nanj-robotics/geni_craner/geni_craner_description/meshes/link6.STL

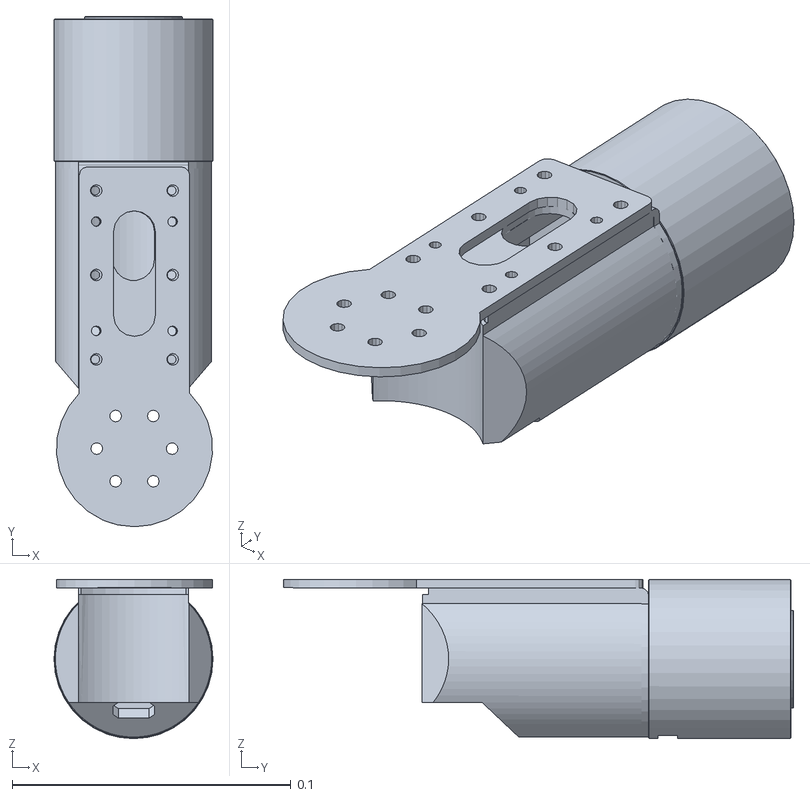
[picture p4: CAD file, 2026-08-13]
geni_craner_description/meshes/link6.STL
0.057 x 0.183 x 0.0571
