nanj-robotics/geni_craner/geni_craner_description/meshes/base_link.STL

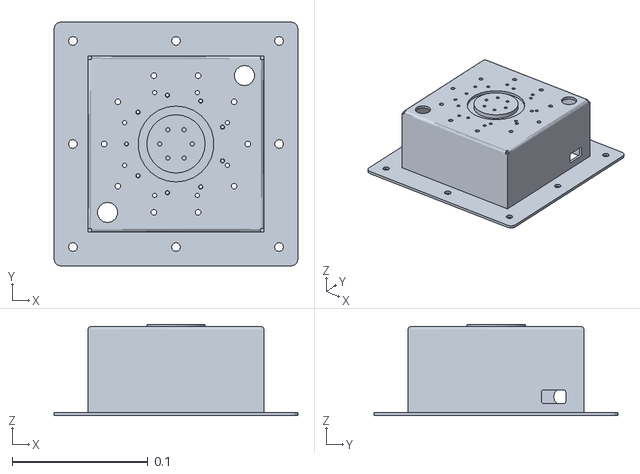
[picture p5: CAD file, 2026-08-13]
geni_craner_description/meshes/base_link.STL
0.18 x 0.18 x 0.0675
