nanj-robotics/geni_craner/geni_craner_description/meshes/link1.STL

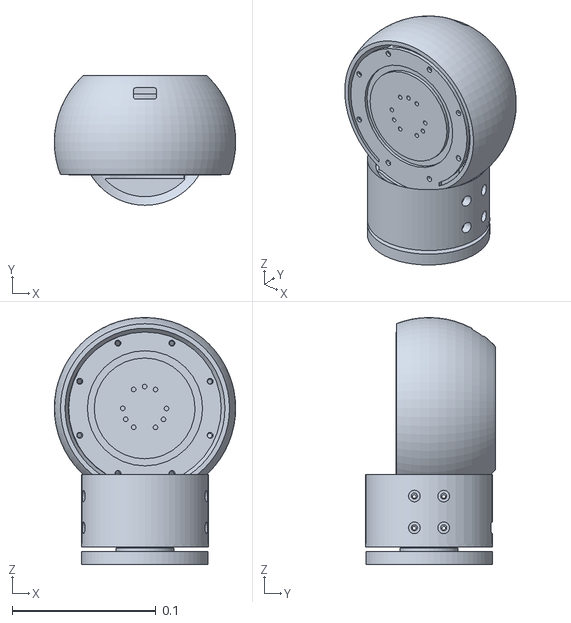
[picture p6: CAD file, 2026-08-13]
geni_craner_description/meshes/link1.STL
0.126 x 0.09 x 0.172
