nanj-robotics/geni_craner/geni_craner_description/meshes/link3.STL

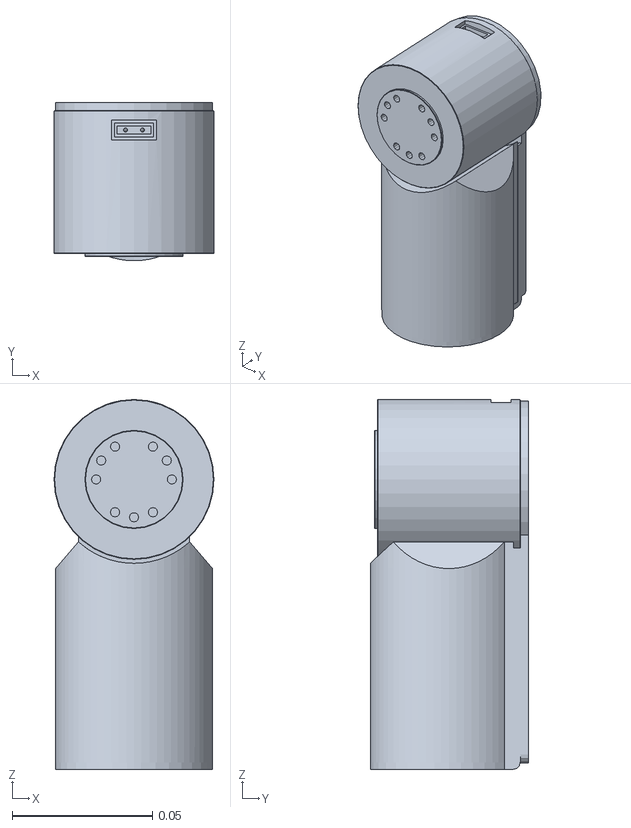
[picture p7: CAD file, 2026-08-13]
geni_craner_description/meshes/link3.STL
0.057 x 0.0565 x 0.132
