nanj-robotics/geni_craner/geni_craner_description/meshes/link2.STL

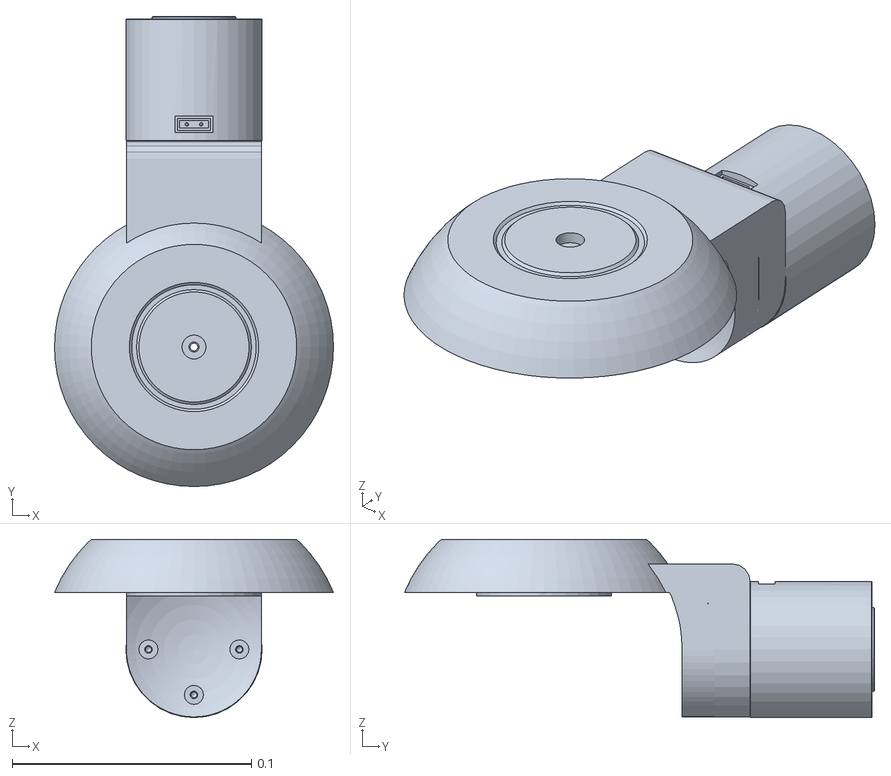
[picture p8: CAD file, 2026-08-13]
geni_craner_description/meshes/link2.STL
0.117 x 0.197 x 0.0745
