nanj-robotics/geni_craner/geni_craner_description/meshes/link7_gripper.STL

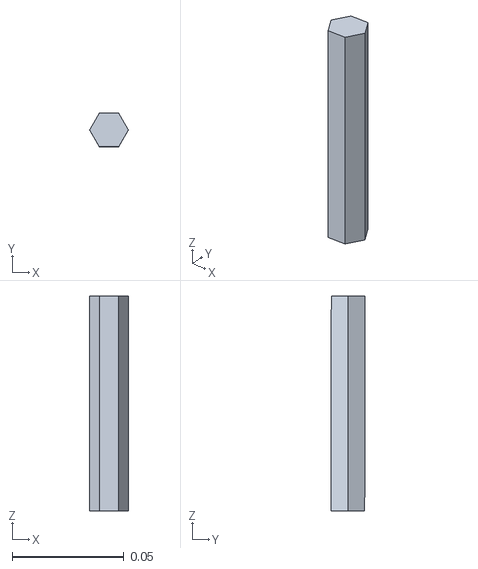
[picture p9: CAD file, 2026-08-13]
geni_craner_description/meshes/link7_gripper.STL
0.0173 x 0.015 x 0.096
