nanj-robotics/geni_craner/(list of files, cad)

Other CAD files:
geni_craner_description/meshes/link4.STL
geni_craner_description/meshes/link5.STL
