nanj-robotics/geni_craner/geni_craner_moveit_config/config/initial_positions.yaml

# Default initial positions for geni_craner's ros2_control fake system

initial_positions:
  joint1: 0
  joint2: 0
  joint3: 0
  joint4: 0
  joint5: 0
  joint6: 0
  joint7: 0
