nanj-robotics/geni_craner/geni_craner_moveit_config/config/ompl_planning.yaml

planning_plugin: ompl_interface/OMPLPlanner
request_adapters: >-
  default_planner_request_adapters/AddTimeOptimalParameterization
  default_planner_request_adapters/FixWorkspaceBounds
  default_planner_request_adapters/FixStartStateBounds
  default_planner_request_adapters/FixStartStateCollision
  default_planner_request_adapters/FixStartStatePathConstraints
start_state_max_bounds_error: 0.1

planner_configs:
  RRTConnect:
    type: geometric::RRTConnect
    range: 0.0
  RRT:
    type: geometric::RRT
    range: 0.0
    goal_bias: 0.05
  RRTstar:
    type: geometric::RRTstar
    range: 0.0
    goal_bias: 0.05
    delay_collision_checking: 1
  PRM:
    type: geometric::PRM
    max_nearest_neighbors: 10
  PRMstar:
    type: geometric::PRMstar
  KPIECE:
    type: geometric::KPIECE
    range: 0.0
    goal_bias: 0.05
    border_fraction: 0.9
  BKPIECE:
    type: geometric::BKPIECE
    range: 0.0
    border_fraction: 0.9
  EST:
    type: geometric::EST
    range: 0.0
    goal_bias: 0.05
  TRRT:
    type: geometric::TRRT
    range: 0.0
    goal_bias: 0.05
    max_states_failed: 10
    temp_change_factor: 2.0
    min_temperature: 10e-10
    init_temperature: 10e-6

geni_craner:
  default_planner_config: RRTConnect
  planner_configs:
    - RRTConnect
    - RRT
    - RRTstar
    - KPIECE
    - BKPIECE
    - EST
    - PRM
    - PRMstar
    - TRRT
  projection_evaluator: joints(joint1,joint2,joint3,joint4,joint5,joint6,joint7)
  longest_valid_segment_fraction: 0.005
