nanj-robotics/geni_craner/(commit log)

2026-08-13 init:geni_craner机械臂ros2源码
    [base_link.STL, geni_craner.csv, geni_craner.ros2_control.xacro, geni_craner.urdf, geni_craner.urdf.xacro, joint_limits.yaml, link1.STL, link2.STL]
2026-08-17 更新urdf、geni_craner_hardware硬件驱动代码；新增easy_handeye2 easy_handeye2_msgs；新增scripts脚本目录
    [geni_craner.ros2_control.xacro, geni_craner.urdf]
2026-08-19 新增手眼标定验证脚本 verify_calib.py
2026-08-25 零力矩模式中间版
    [geni_craner.ros2_control.xacro, ros2_controllers.yaml]
2026-08-25 增加零力矩模式
    [geni_craner.ros2_control.xacro, ros2_controllers.yaml]
2026-08-26 add robot arm photo for readme
